MM-Soft-Atari/sio2ide/HARDWARE/PCBdata4/README.TXT

Dane do wykonania obwodu drukowanego.

        SIO2IDE4.PCB

        - plytka jednostronna (85,7mm x 66,4mm)
        - laminat szklano-epoksydowy
        - opis elementow
        - maska

W sklad dokumentacji wchodza nastelujace pliki:
        - plik z aperturami
                                *.APT
        - pliki z opisem wiercen
                                *.DRL
                                *.DRR
                                *.TXT
        - pliki GERBER z opisem warstw
                        - warstwa miedzi (Bottom Layer)
                                *.GBL
                        - maska (Bottom Solder Mask)
                                *.GBS
                        - warstwa opisu elementow (Top Overal)
                                *.GTO
                        - obrys plytki (Keep Out)
                                *.GKO

Na plytce jest punkt odniesienia wspolny dla wszystkich warstw (REF).

Kontakt:

Marek Mikolajewski
Gdansk
tel   : 0501 627827
email : Marek_Mikolajewski@hoga.pl
