MM-Soft-Atari/sio2ide/VER.400/DOCS/SIO2IDE_4_PCB.gif

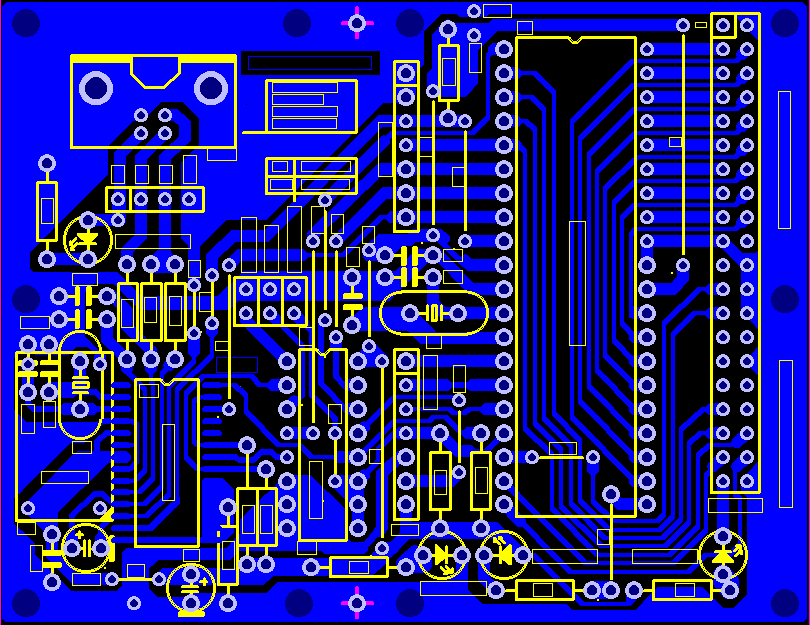
VER.400/DOCS/SIO2IDE_4_PCB.gif
