MM-Soft-Atari/sio2ide/DOCS/SIO2IDE_BOM.xls

Lp | Nazwa | Oznaczenia | Sztuk | Cena/Szt | Brutto | Uwagi
0 | Kompletne SIO2IDE |  | 10
1 | AT90S8515-8PC | U1 | 10 | 25.90 | 315.98
2 | QMIM4.9152 | Y1 | 10 | 1.64 | 20.00 | brak w MS
3 | LED5MMGN | PWR_LED SIO_LED | 20 | 0.16 | 3.90 | paczka 100szt = 16zł
4 | LED5MMRT | BSY_LED IDE_LED | 20 | 0.16 | 3.90 | paczka 100szt = 15,6zł
5 | 470R | R1 R2 R3 R4 | 40 | 0.05 | 2.44 | paczka 100szt = 5zł
6 | 4k7 | R10 | 10 | 0.05 | 0.61 | paczka 100szt = 5zł
7 | KOS22UF/16 | C1 | 10 | 0.15 | 1.83
8 | CCPF033-2.5 | C2 C3 | 20 | 0.10 | 2.44
9 | WSL80Z | IDE_IO | 5 | 1.45 | 8.85 | na 2 SIO2IDE
10 | WSL40Z | ISP_IO | 2 | 0.99 | 2.42 | na 5 SIO2IDE
11 | NSG25-8 | SIO_IO | 10 | 0.57 | 7.00 | brak w MS
12 | NSL25-8W | SIO_IO | 10 | 0.82 | 10.00 | brak w MS
13 | JUMP-SW | HD1_ZW MS_ZW | 20 | 0.13 | 3.17
14 | JUMP-RT | INIT_ZW | 10 | 0.13 | 1.59
15 | DIL40EM |  | 10 | 0.38 | 4.64
16 | Płytka SIO2IDE | SIO2IDE_PCB | 10 | 10.00 | 100.00
 |  |  | wartość | = | 488.76 | zł
 |  |  | rabat | - | 5 | %
 |  |  | koszty | - | 7.00 | zł
 | MS Elektronik |  | zapłata | = | 665.00 | zł
 | 81-595 Gdynia, ul. Makuszyńskiego 30 |  | zysk | = | 169.24 | zł
 | tel. +48 58 629-24-69, tel./fax +48 58 629-32-00
 | email: info@mselektronik.com.pl
