MM-Soft-Atari/sio2ide/(list of files, drawings)

Other design files:
HARDWARE/PCBdata4/SIO2IDE4.PCB
HARDWARE/PCBdata/SIO2IDE.PCB
HARDWARE/SIO2IDE4.PCB
HARDWARE/SIO2IDE4a.PCB
HARDWARE/SIO2IDE.PCB
